max-bispham/rp2040-haltech-SD-DAQ/kicad/carrier_board/carrier_board.kicad_pcb

## KiCad design kicad/carrier_board/carrier_board.kicad_pcb (2026-10-22)

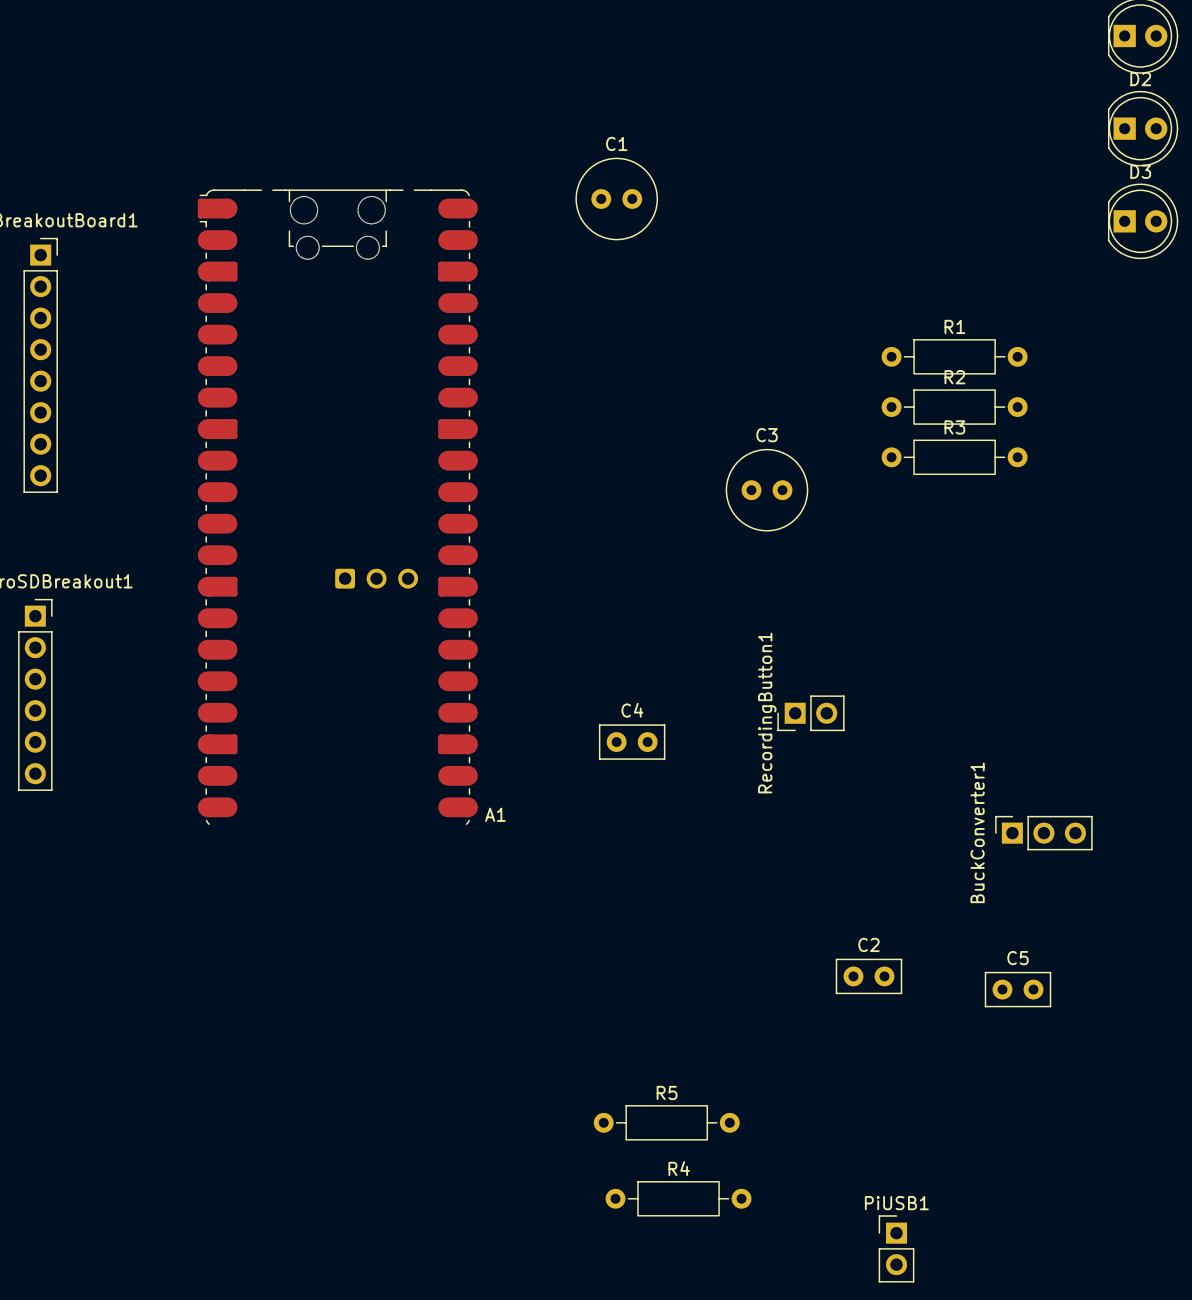
[picture p1: board carrier_board.kicad_pcb from above]

Board: 2 copper layers, 19 parts (0 on the bottom side), 18 nets, no tracks yet.

Parts:
A1: RaspberryPi_Pico_W; RaspberryPi_Pico_W_SMD_HandSolder
BuckConverter1: Conn_01x02; PinSocket_1x03_P2.54mm_Vertical
C1: 22µf; C_Radial_D6.3mm_H11.0mm_P2.50mm
C2, C4, C5: 100nf; C_Disc_D5.0mm_W2.5mm_P2.50mm
C3: 10µf; C_Radial_D6.3mm_H11.0mm_P2.50mm
D1, D2, D3: LED; LED_D5.0mm
PiUSB1: Conn_01x02; PinHeader_1x02_P2.54mm_Vertical
R1, R2, R3: R; R_Axial_DIN0207_L6.3mm_D2.5mm_P10.16mm_Horizontal
R4: 4k7; R_Axial_DIN0207_L6.3mm_D2.5mm_P10.16mm_Horizontal
R5: 330; R_Axial_DIN0207_L6.3mm_D2.5mm_P10.16mm_Horizontal
RecordingButton1: Conn_01x02; PinHeader_1x02_P2.54mm_Vertical
SPIMicroSDBreakout1: Conn_01x06; PinSocket_1x06_P2.54mm_Vertical
USBCBreakoutBoard1: Conn_01x08; PinSocket_1x08_P2.54mm_Vertical

Connections:
+3.3V: A1.36 (3V3), D1.2 (A), SPIMicroSDBreakout1.6 (3v3)
+3V3: C3.1, C4.1, R4.1
+5V: A1.39 (VSYS), BuckConverter1.1 (+), C1.1, C2.1
/BTN_REC: A1.4 (GPIO2), R5.1
/CS: A1.17 (GPIO13), SPIMicroSDBreakout1.5 (CS)
/D+: PiUSB1.1 (D+), USBCBreakoutBoard1.3 (D+)
/D-: PiUSB1.2 (D-), USBCBreakoutBoard1.4 (D-)
/LED_REC: A1.5 (GPIO3), D2.2 (A)
/LED_USB: A1.11 (GPIO8), D3.2 (A)
/MISO: A1.16 (GPIO12), SPIMicroSDBreakout1.2 (MISO)
/MOSI: A1.15 (GPIO11), SPIMicroSDBreakout1.4 (MOSI)
/SCK: A1.14 (GPIO10), SPIMicroSDBreakout1.3 (CLK)
/USB5v: A1.40 (VBUS), USBCBreakoutBoard1.7 (VBUS)
GND: A1.3 (GND), A1.8 (GND), A1.13 (GND), A1.18 (GND), A1.23 (GND), A1.28 (GND), A1.33 (AGND), A1.38 (GND), BuckConverter1.2 (-), C1.2, C2.2, C3.2, C4.2, C5.2, R1.1, R2.1, R3.1, RecordingButton1.2, SPIMicroSDBreakout1.1 (GND), USBCBreakoutBoard1.8 (GND)
unnamed: D1.1 (K), R1.2
unnamed: D2.1 (K), R2.2
unnamed: D3.1 (K), R3.2
unnamed: C5.1, R4.2, R5.2, RecordingButton1.1
