max-bispham/rp2040-haltech-SD-DAQ/(commit log)

2026-10-22 added kicad project
    [carrier_board.kicad_pcb, carrier_board.kicad_sch]
2026-10-22 schematic progress
    [carrier_board.kicad_sch]
2026-10-22 schematics complete
    [carrier_board.kicad_pcb]
